andrewwpowell/ECG/(list of files, drawings)

Other design files:
ECE3750-FinalProject-PAPP.ms14
